wykys/kostka/README.md

# Elektronická hrací kostka

(40*40)mm^2
Napájení RC2032

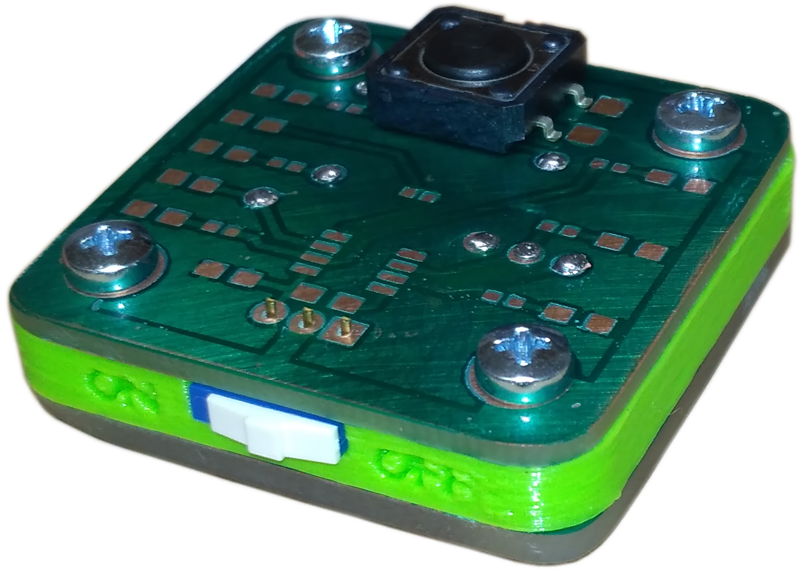
[picture p1: img/zelena.png]
demo
