wykys/kostka/navod/osaz.tex

\section*{Osazování}

Osazování je nejlepší provádět od nejmenších součástek po ty největší. Je tedy vhodné napřed osadit LED diody v pouzdře 0603, poté rezistory a kondenzátory v pouzdrech 0805. Následně mikrokontrolér v pouzdře SO-8 a nakonec tlačítko. Vypínač je vhodné přiletovat až když je kostka smontovaná, tak aby dobře pasoval do předchystaného otvoru.

Pozor na správnou polarizaci LED diod! Dioda je polarizovaná součástka, která má anodu a katodu. Katoda je označena malým kolečkem z horní strany a zelenou značkou ze strany spodní. Pokud budou diody nesprávně otočeny nebudou svítit. Správně osadit je třeba i mikrokontrolér, který při nevhodném osazení shoří. V osazovacím plánu je jednička mikrokontroléru označena čárkou. Poslední věcí, na kterou je třeba dávat obzvláště pozor je správné otočení baterie. Kladný pól, ten větší na, kterém je napsáno obvykle +, musí být položen na velkou plošku, spodní destičky, na které nejsou součástky. Záporný pól, ten menší je třeba připojit k malé plošce, která je na straně spojů hlavní destičky. Při špatném vložení baterie bude kostka zničena! Tak hodně štěstí.

\begin{figure}[H]
  \centering
  
  \caption{Označení katody LED diody LTW-C190DA5}
  \label{img:1}
\end{figure}
