wykys/kostka/navod/navod.tex

\documentclass[11pt,a4paper]{article}
\usepackage[utf8]{inputenc}
\usepackage[czech]{babel}
\usepackage[T1]{fontenc}
\usepackage{amsmath}
\usepackage{amsfonts}
\usepackage{amssymb}
\usepackage[total={18.5cm, 25cm}, top=1cm, bottom=0.5cm, left=1.25cm, includehead]{geometry}
\usepackage{fancyhdr} %záhlaví
\usepackage{float} % H aby neuplavali
\usepackage{pdfpages}

\usepackage{listings}
\usepackage{color}
 
\definecolor{codegreen}{rgb}{0,0.6,0}
\definecolor{codegray}{rgb}{0.5,0.5,0.5}
\definecolor{codepurple}{rgb}{0.58,0,0.82}
\definecolor{backcolour}{rgb}{0.95,0.95,0.92}
 
\lstdefinestyle{mystyle}{
    backgroundcolor=\color{backcolour},   
    commentstyle=\color{codegreen},
    keywordstyle=\color{magenta},
    numberstyle=\tiny\color{codegray},
    stringstyle=\color{codepurple},
    basicstyle=\footnotesize,
    breakatwhitespace=false,         
    breaklines=true,                 
    captionpos=b,                    
    keepspaces=true,                 
    numbers=left,                    
    numbersep=5pt,                  
    showspaces=false,                
    showstringspaces=false,
    showtabs=false,                  
    tabsize=2
}
 
\lstset{style=mystyle}

\pagestyle{fancy}
\fancyhf{}
% jednostranná sazba
\fancyhead[L]{
	%\begin{tabular}{lr}
	%	\textsc{Jan Vykydal} \\ 
	%	186240 
	%\end{tabular}
	\begin{minipage}{1.7cm}
		
	\end{minipage}
}
\fancyhead[C]{
	\begin{tabular}{c}
		\textsc{Návod k sestavení} \\
		\textsc{Elektronické Kostky}
	\end{tabular} 
}
\fancyhead[R]{
	\begin{tabular}{lr}
		\multicolumn{2}{r}{FEKT UREL} \\
		\textsc{List:} & \thepage/\pageref{konec} 
	\end{tabular} 
}

\author{Jan Vykydal}
\title{Elektronická kostka}
\begin{document}

	\input{sch.tex}	
	\input{osaz.tex}
	\input{jak.tex}
	\input{zdrojak.tex}
	
	\label{konec}

\end{document}
