wykys/kostka/navod/jak.tex

\section*{Jak to funguje?}

Srdcem kostky je malý mikrokontrolér ATTINY13, což je osmibitový čip s architekturou AVR. Jeho větší bratříčky lze nalézt třeba v ARDUINu. Po zapnutí a vnitřním resetování mikrokontrolér nastaví svůj interní čítač tak, aby čítal od nuly do pětky. Dále nastaví přerušení na sestupnou hranu, které nastane při stisku tlačítka. Poté co vše nastaví, tak skočí do nekonečné smyčky.

Když je stisknuto tlačítko, tak nastane přerušení. Program je přerušen a po uložení adresy z programového čítače (to je místo kde se v programu právě nacházíme) do zásobníku (což je paměť typu Last In First Out) skočí na obslužný podprogram přerušení. Dokud je tlačítko stisknuto,  je na výstupních pinech generována posloupnost tak, že LED diody vytváří efekt točící se úsečky - naznačuje míchání kostkou.

Po uvolnění tlačítka dojde k načtení aktuální hodnoty čítače, která je pak pomocí kódovací tabulky převedena na odpovídající zobrazení hodnoty vrhu kostky. Při zobrazování čísla ještě číslo třikrát zabliká, během doby kdy bliká nejde losovat další číslo. To je kvůli omezení podvádění několika rychlými stisky za sebou.

Když skončí podprogram přerušení, tak je ze zásobníku opět vyzvednuta adresa a program se opět vrátí do nekoneční smyčky.

Rezistory $R_1 - R_7$ je nastaven pracovní proud LED diody, bez kterých by mohlo dojít ke zničení LED diod nadměrným proudem. Rezistor $R_8$ zabezpečuje správnou funkci resetu mikrokontroléru po zapnutí. Kondenzátor $C_1$ slouží k eliminaci zákmitů napětí při stisku či uvolnění tlačítka.
