wykys/kostka/navod/sch.tex

\begin{figure}[H]
  \centering
  
  \caption{Schéma zapojení}
  \label{img:1}
\end{figure}

\begin{table}[H]
  \begin{center}
    \begin{tabular}{c c}
      \begin{minipage}{0.48\textwidth}
        \begin{figure}[H]
          \centering
          
          \caption{Osazovací plán strana součástek}
          \label{img:2}
        \end{figure}
      \end{minipage}
  			&  				
      \begin{minipage}{0.48\textwidth}
        \begin{figure}[H]
          \centering
          
          \caption{Osazovací plán strana spojů}
          \label{img:3}
        \end{figure}
      \end{minipage}
    \end{tabular}
  \end{center}	
\end{table}

\begin{table}[H]
  \begin{center}
    \begin{tabular}{c c}
      \begin{minipage}{0.48\textwidth}
        \begin{figure}[H]
          \centering
          
          \caption{Spodní destička, slouží jako přívod kladného pólu baterie k hlavní desce}
          \label{img:4}
        \end{figure}
      \end{minipage}
  			&  				
      \begin{minipage}{0.48\textwidth}
        \begin{table}[H]
        	\centering
        	\caption{Seznam součástek}
        	\vspace{5mm}
        	\begin{tabular}{c | c | c}
        		$R_1 - R_7$ & $100~\Omega$ & rezistor \\\hline
        		$R_8$ & $10~k\Omega$ & rezistor \\\hline
        		$C_1$, $C_2$ & $100~nF$ & kondenzátor \\\hline
        		$D_1 - D_7$ & LTW-C190DA5 & LED \\\hline
        		$IC_1$ & ATTINY13A-SSU & mikrokontorlér \\\hline
        		$SW_1$ & B3FS-4002P & tlačítko \\\hline
        		$SW_2$ & ESP2010 & přepínač \\\hline
        		$BT_1$ & CR2032 & baterie \\\hline
        		$M_1 - M_4$ & $2\cdot$ šroub a sloupek M3  & mechanické díly
        	\end{tabular}
        \end{table}
      \end{minipage}
      \\
      \begin{minipage}{0.48\textwidth}
        \begin{figure}[H]
          \centering
          
          \caption{ukázka uložení distančních sloupků a baterie CR2032}
          \label{img:6}
        \end{figure}
      \end{minipage}
  			&  				
      \begin{minipage}{0.48\textwidth}
        \begin{figure}[H]
          \centering
          
          \caption{smontovaná kostka bez osazených součástek}
          \label{img:7}
        \end{figure}
      \end{minipage}
    \end{tabular}
  \end{center}	
\end{table}
