wykys/kostka/img/kostka.png

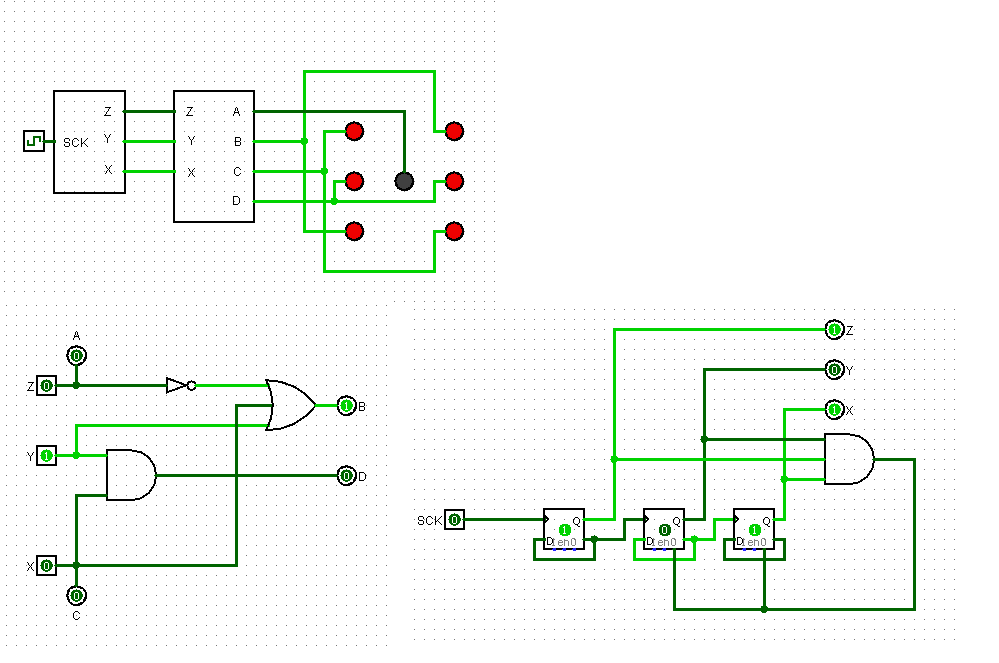
img/kostka.png
