wykys/kostka/img/kostka_mong.png

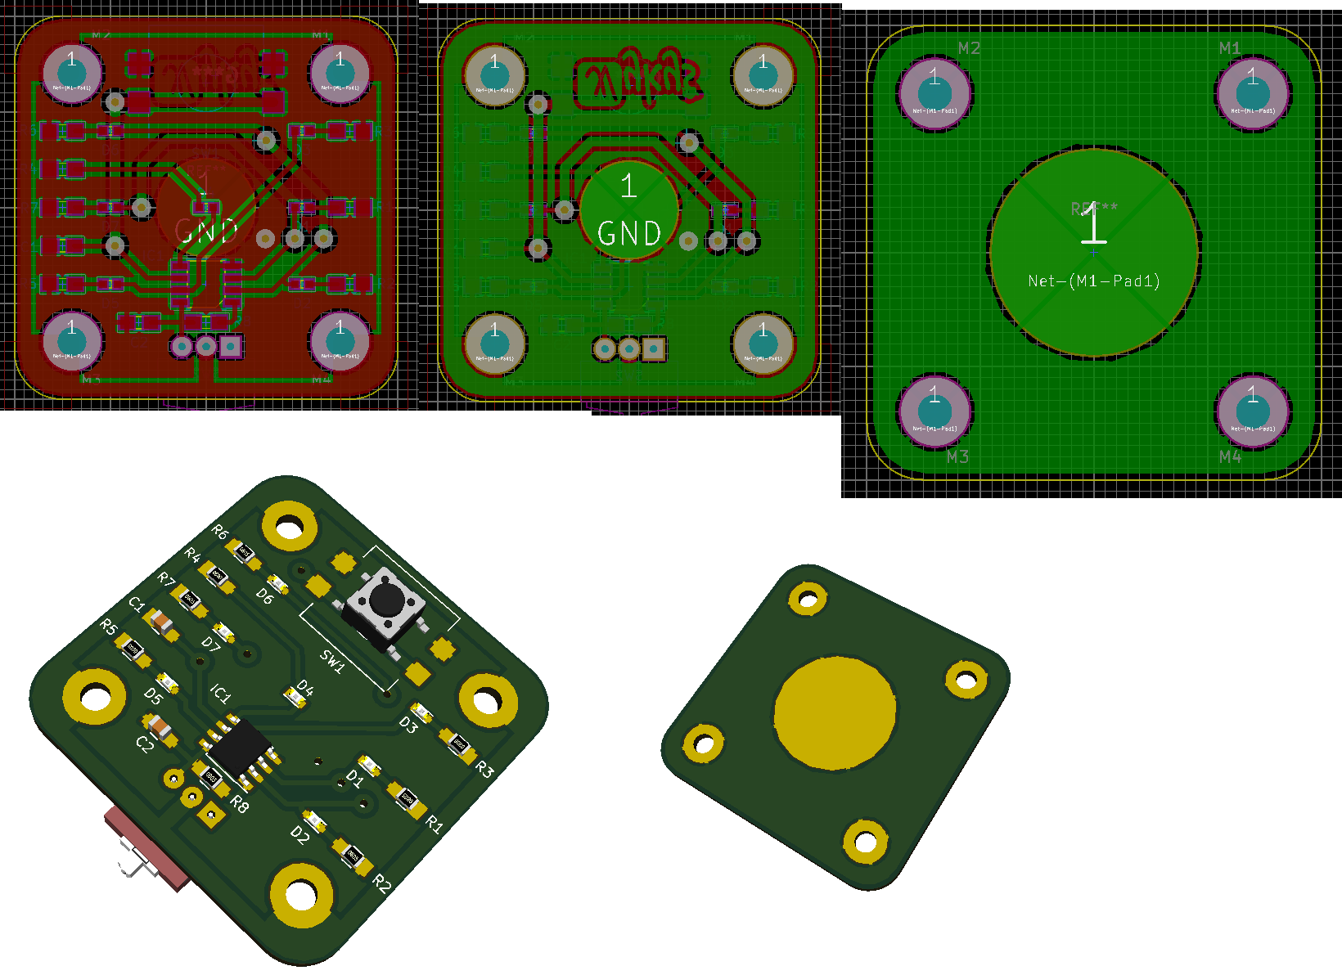
img/kostka_mong.png
