wykys/kostka/kostka.SLDASM

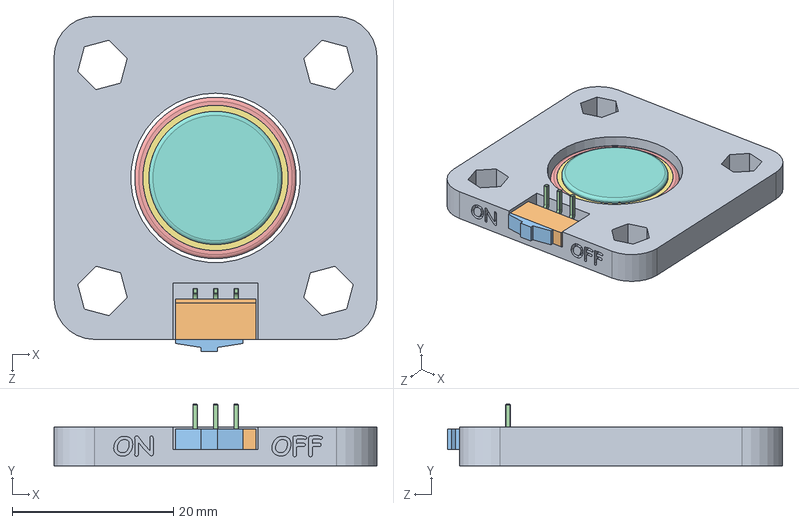
[picture p4: CAD file, 2016-12-13]
kostka.SLDASM
40.0 x 7.65 x 41.5 mm
krabca
zaklad
cudlik
vyvod x 3
plus
potisk
izolace
minus
