wykys/kostka/vypinac/vypinac.SLDASM

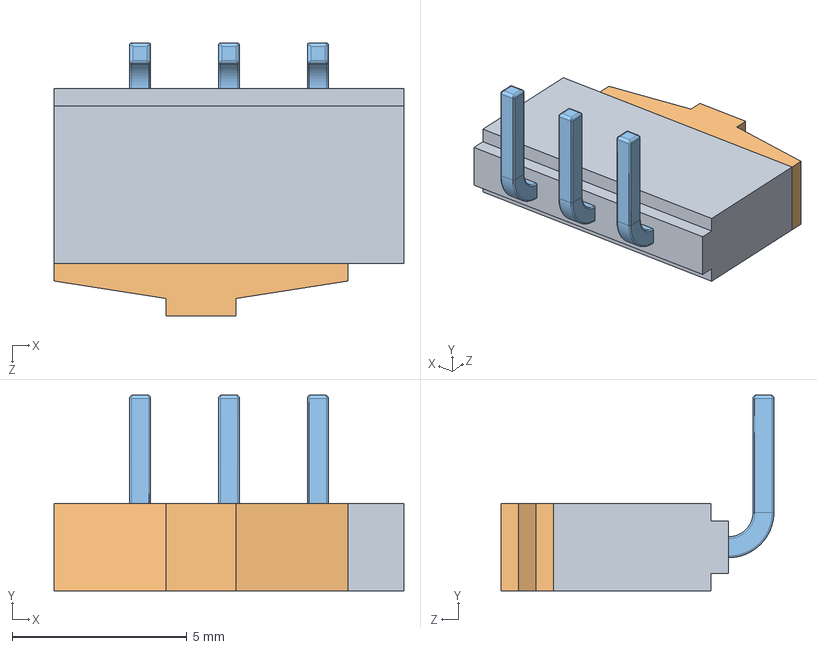
[picture p5: CAD file, 2016-12-13]
vypinac/vypinac.SLDASM
10.0 x 5.60 x 7.80 mm
zaklad
cudlik
vyvod x 3
