wykys/kostka/chassis/krabca_s_txt.STL

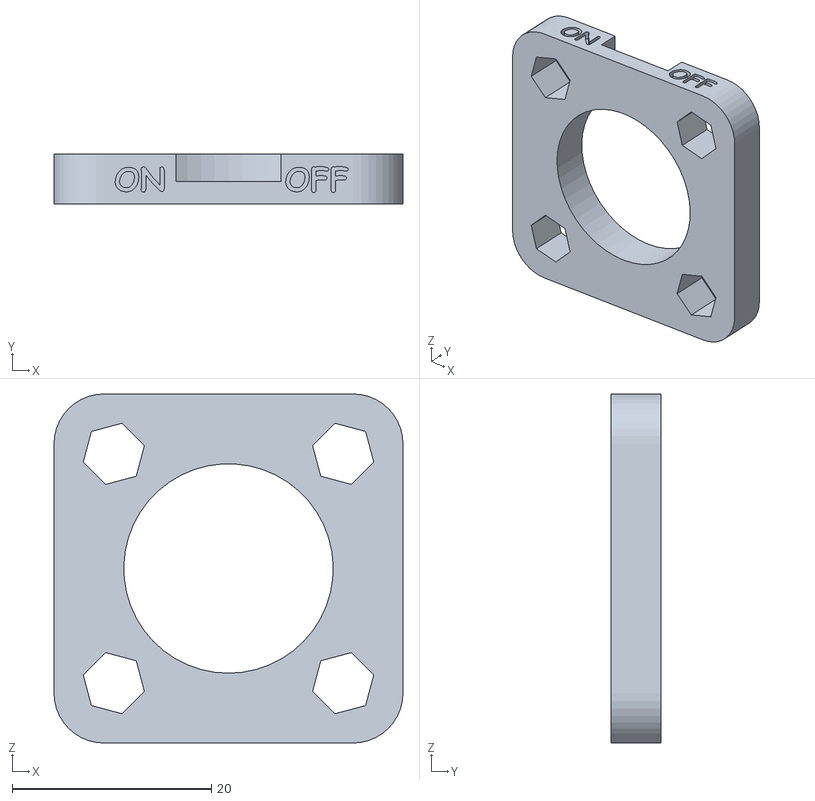
[picture p6: CAD file, 2016-12-13]
chassis/krabca_s_txt.STL
35.0 x 5.00 x 35.0
