wykys/kostka/vypinac/cudlik.SLDPRT

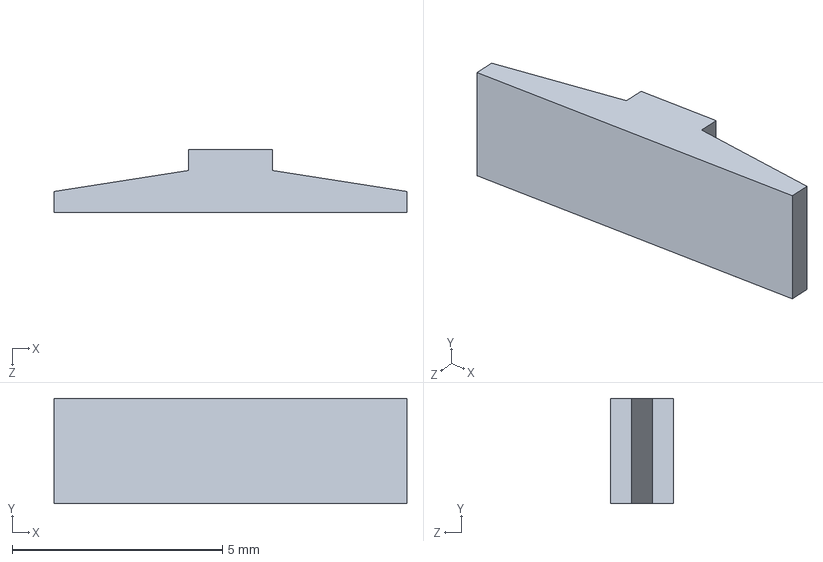
[picture p7: CAD file, 2016-12-13]
vypinac/cudlik.SLDPRT
8.40 x 2.50 x 1.50 mm
