wykys/kostka/chassis/krabca_40.STL

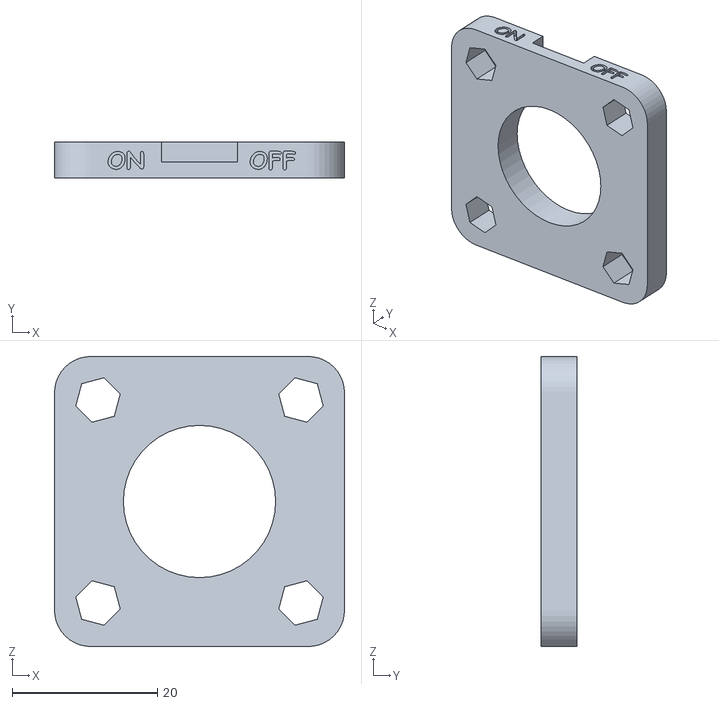
[picture p8: CAD file, 2016-12-13]
chassis/krabca_40.STL
40.0 x 5.00 x 40.0
