wykys/kostka/vypinac/zaklad.SLDPRT

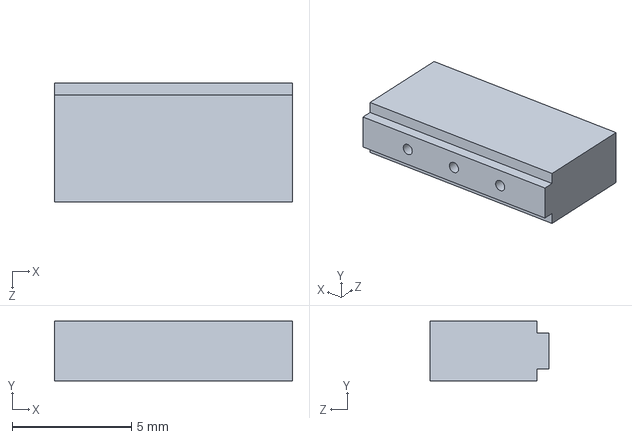
[picture p9: CAD file, 2016-12-13]
vypinac/zaklad.SLDPRT
10.0 x 2.50 x 5.00 mm
