wykys/kostka/chassis/krabca.SLDPRT

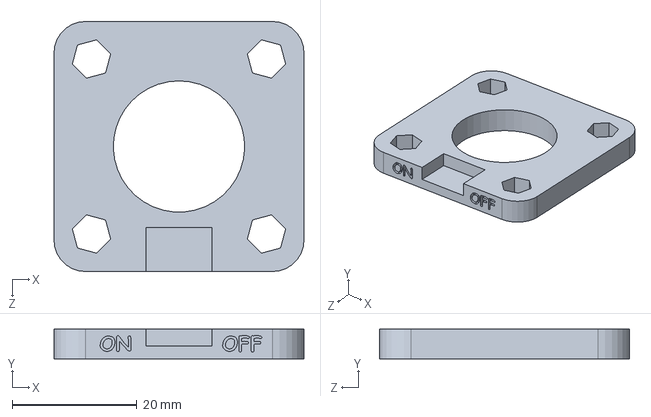
[picture p10: CAD file, 2016-12-13]
chassis/krabca.SLDPRT
40.0 x 4.80 x 40.0 mm
