wykys/kostka/vypinac/vyvod.SLDPRT

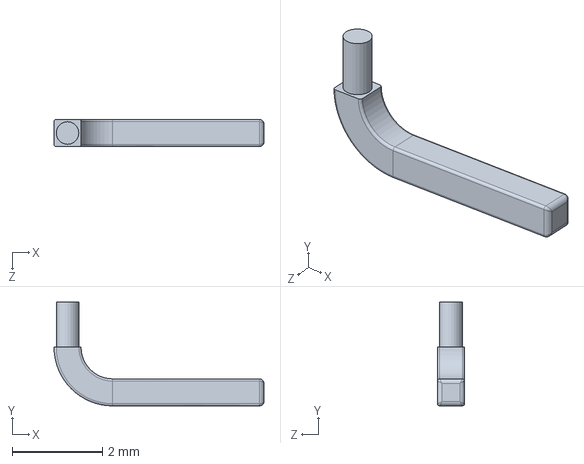
[picture p11: CAD file, 2016-12-13]
vypinac/vyvod.SLDPRT
4.65 x 2.30 x 0.6 mm
