wykys/kostka/(list of files, cad)

Other CAD files:
chassis/krabca_bez_txt.STL
chassis/krabca.SLDDRW
chassis/krabca.STL
