wykys/kostka/design/kostka.pdf

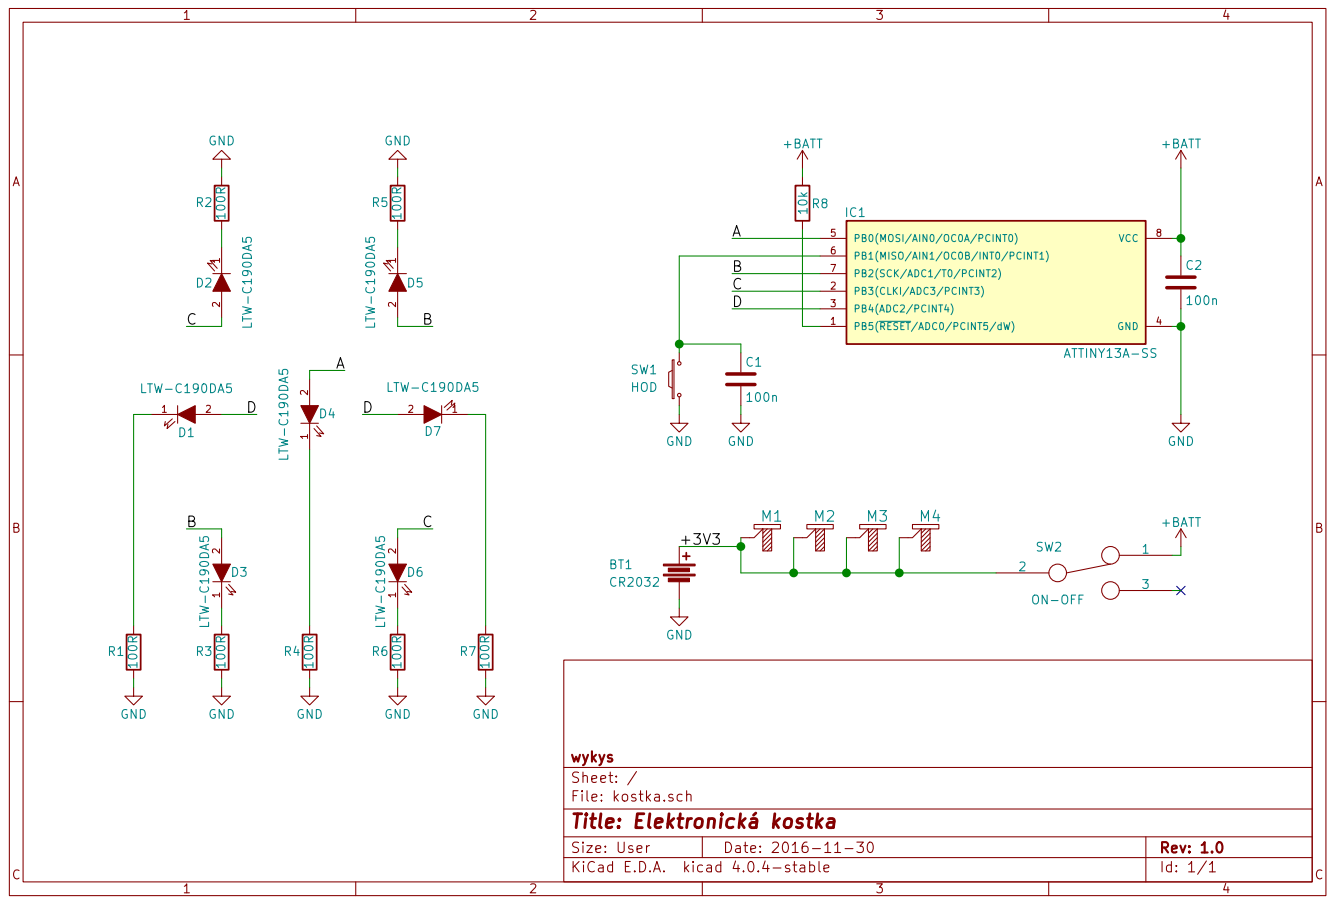
[picture p12: page 1]

1 2 D4 LTW-C190DA5 R7 100R GND GND GND GND GND GND GND A

File: kostka.sch Sheet: / wykys

Id: 1/1 Title: Elektronická kostka
