wykys/kostka/chassis/krabca.PDF

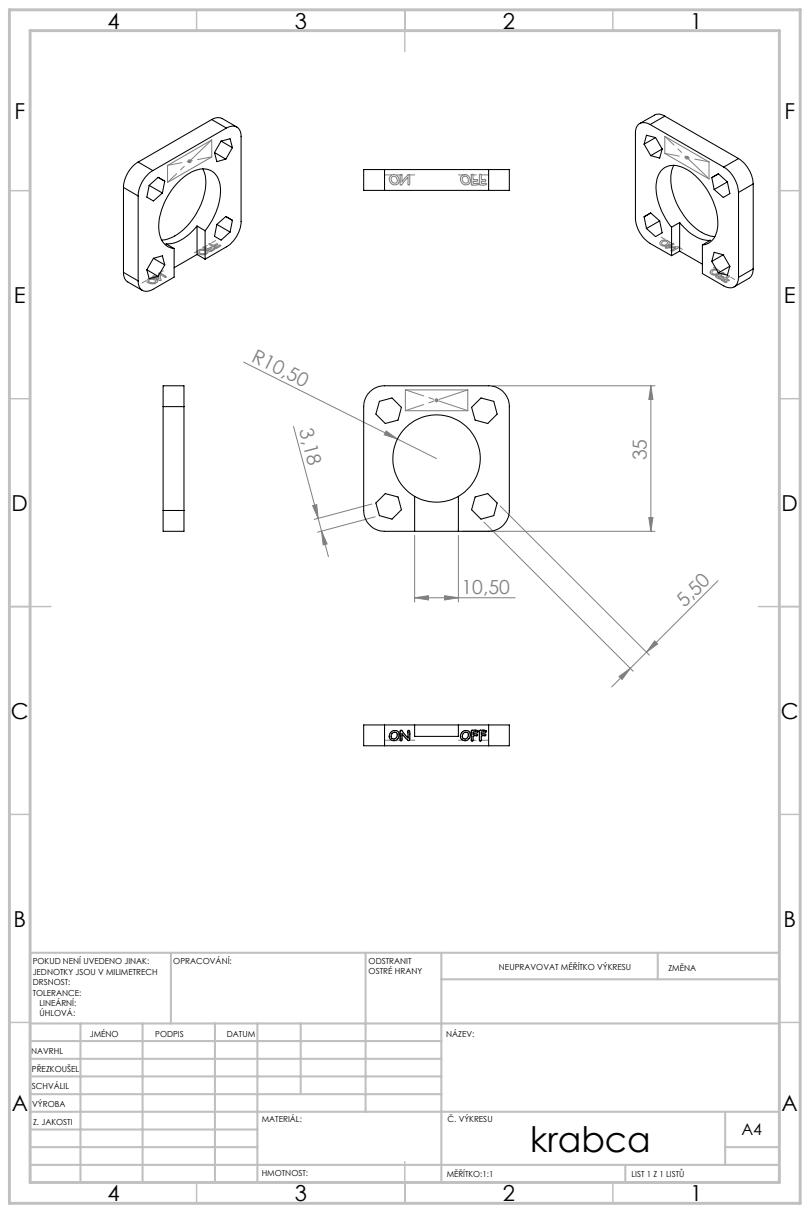
[picture p13: page 1]
MĚŘÍTKO:1:1; LIST 1 Z 1 LISTŮ; NEUPRAVOVAT MĚŘÍTKO VÝKRESU; ZMĚNA; OSTRÉ HRANY; POKUD NENÍ UVEDENO JINAK:; OPRACOVÁNÍ:; JEDNOTKY JSOU V MILIMETRECH

JMÉNO | PODPIS | DATUM | | | | NÁZEV:

NAVRHL
PŘEZKOUŠEL
SCHVÁLIL
VÝROBA
Z. JAKOSTI | | | | MATERIÁL: | Č. VÝKRESU krabca HMOTNOST: | A4
