wykys/kostka/design/sch_doc.pdf

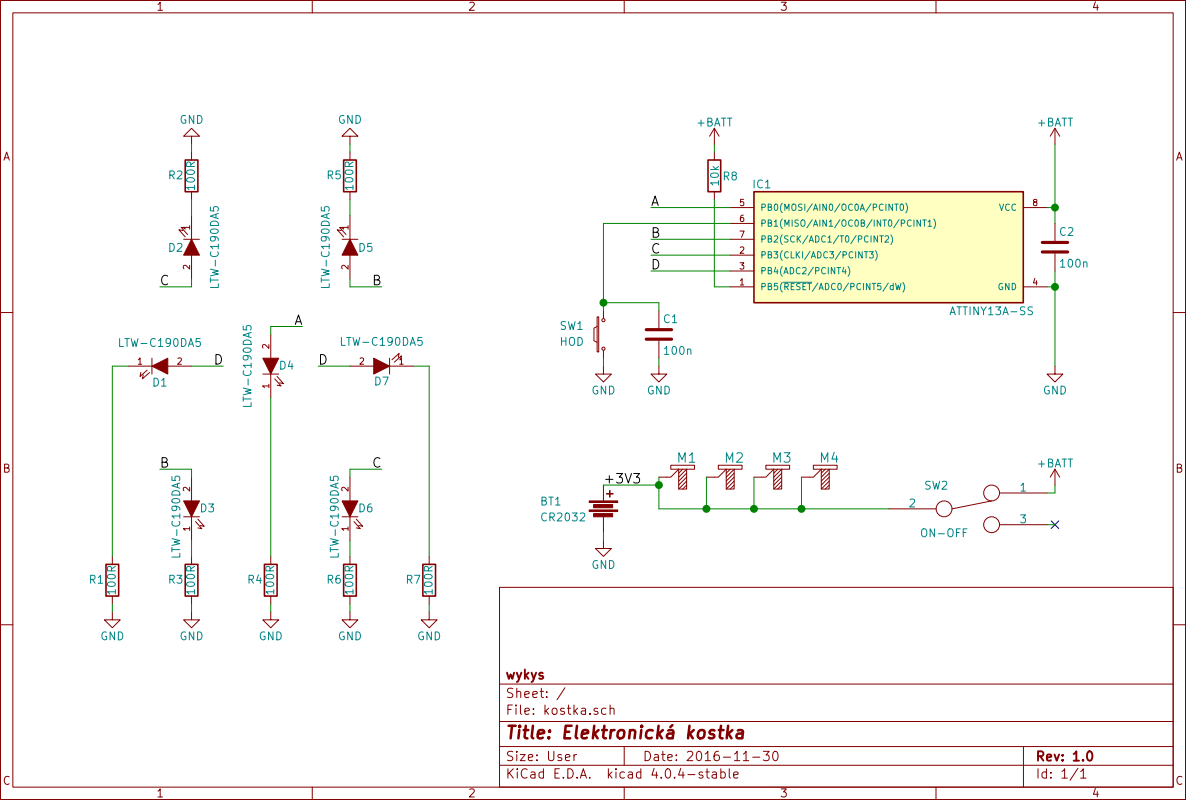
[picture p14: page 1]
