wykys/kostka/design/svg/osazovak_bot.pdf

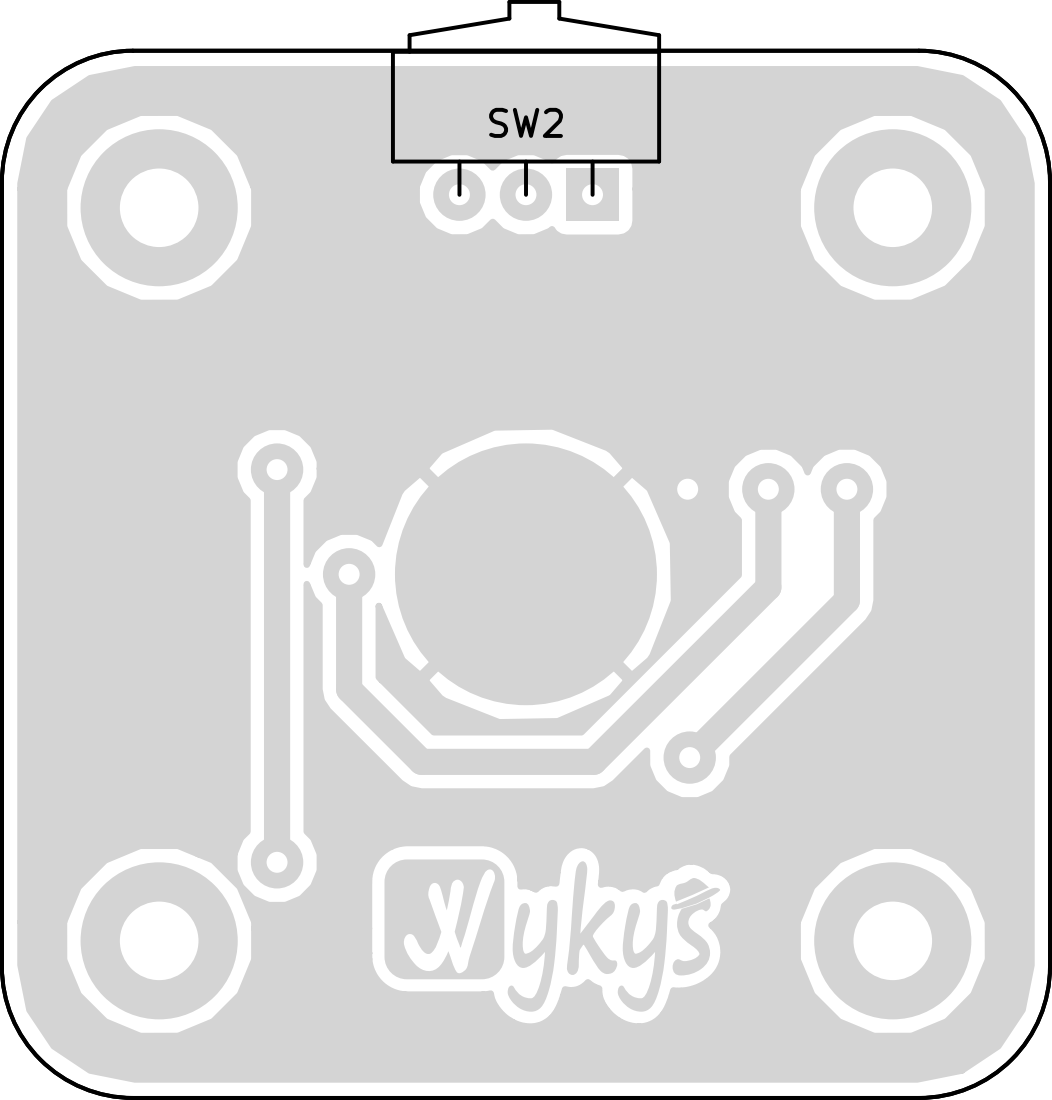
[picture p15: page 1]
