wykys/kostka/design/svg/osazovak_spodek.pdf

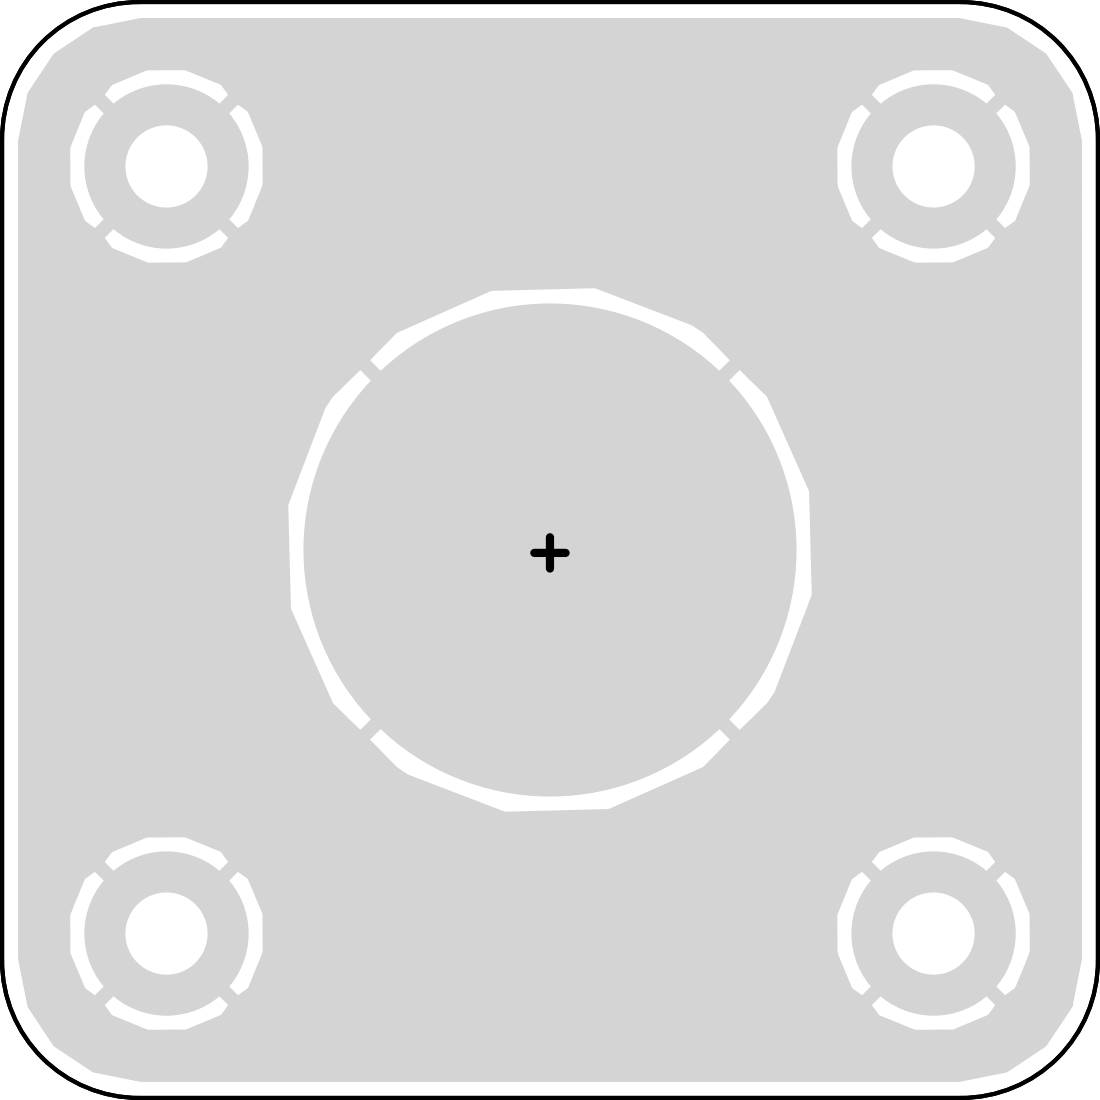
[picture p16: page 1]
