wykys/kostka/design/svg/osazovak_top.pdf

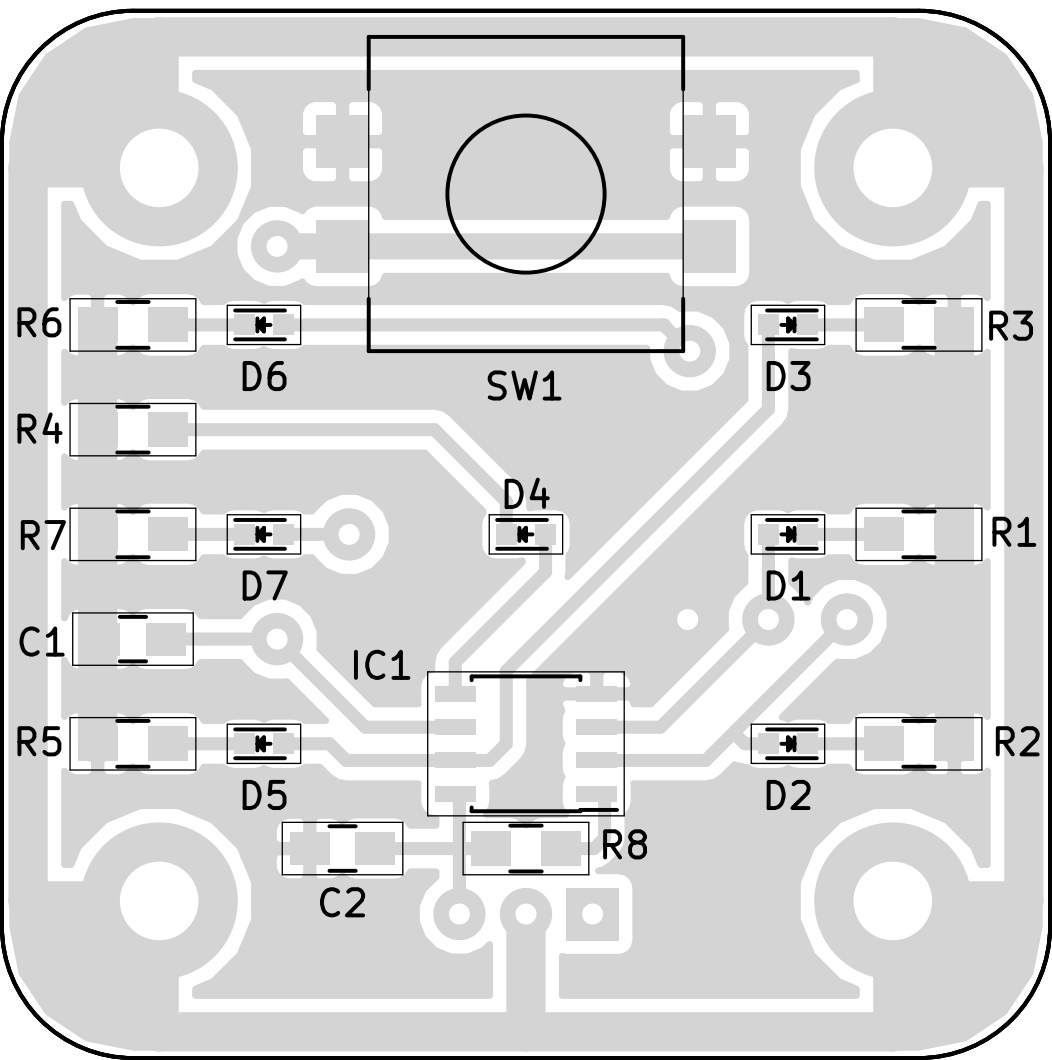
[picture p17: page 1]
