wykys/kostka/img/logo.pdf

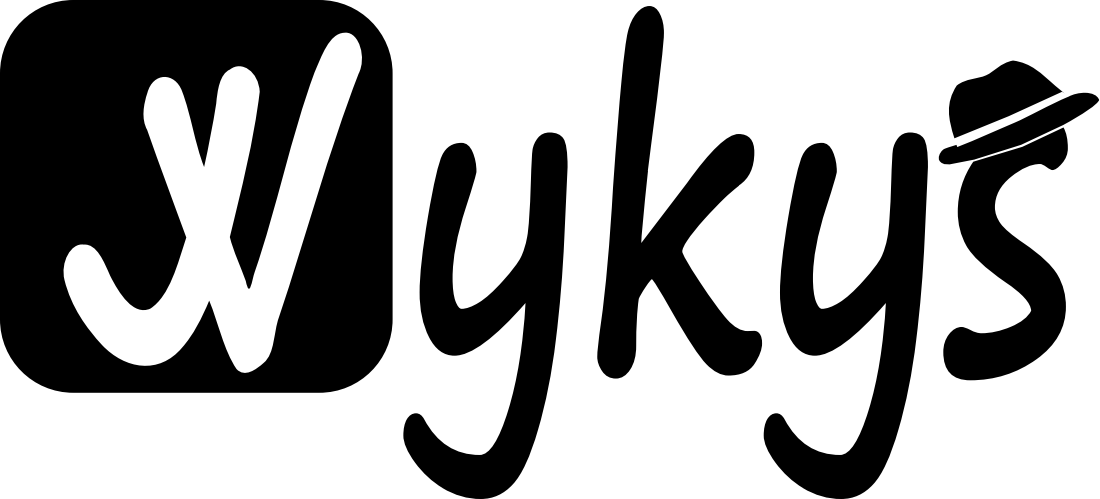
[picture p18: page 1]
