wykys/kostka/(list of files, drawings)

Other design files:
logisim/simulace.circ
