wykys/kostka/design/kostka.kicad_pcb

## KiCad design design/kostka.kicad_pcb (2016-12-13)

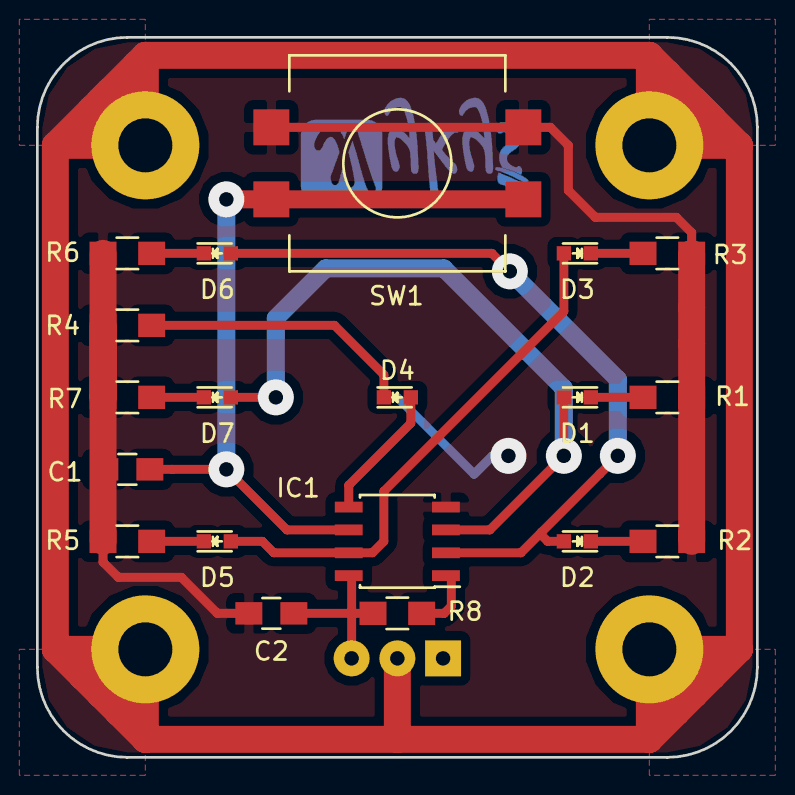
[picture p19: board kostka.kicad_pcb from above]

Board: 2 copper layers, 40.0 x 40.0 mm, 24 parts (1 on the bottom side), 16 nets.

Parts:
C1: 10n; C_0805_HandSoldering
C2: 100n; C_0805_HandSoldering
D1, D2, D3, D4, D5, D6, D7: LED; LED_0603
IC1: ATTINY13A-SS; SOIC-8_3.9x4.9mm_Pitch1.27mm
M1, M2, M3, M4: M3; SolderWirePad_single_0-8mmDrill
R1, R2, R3, R4, R5, R6, R7: R; R_0805_HandSoldering
R8: 10k; R_0805_HandSoldering
SW1: HOD; SW_SPST_PTS645
SW2: ON-OFF; SW_Micro_SPST_Angled

Connections:
/A: D4.2, IC1.5
/B: D3.2, D5.2, IC1.7
/C: D2.2, D6.2, IC1.2
/D: D1.2, D7.2, IC1.3
GND: C1.2, C2.2, IC1.4, R1.1, R2.2, R3.1, R4.1, R5.2, R6.1, R7.1, SW1.1
unnamed: C1.1, IC1.6, SW1.2
unnamed: D1.1, R1.2
unnamed: D2.1, R2.1
unnamed: D3.1, R3.2
unnamed: D4.1, R4.2
unnamed: D5.1, R5.1
unnamed: D6.1, R6.2
unnamed: D7.1, R7.2
unnamed: IC1.1, R8.2
unnamed: M1.1, M2.1, M3.1, M4.1, SW2.2
VDD: C2.1, IC1.8, R8.1, SW2.1
